sarahemm/continuity_tester/README.md

# continuity_tester
Continuity Tester design, optimized for reverse engineering PCBs
