sarahemm/continuity_tester/continuity_tester.brd

## EAGLE design continuity_tester.brd (2018-01-26)

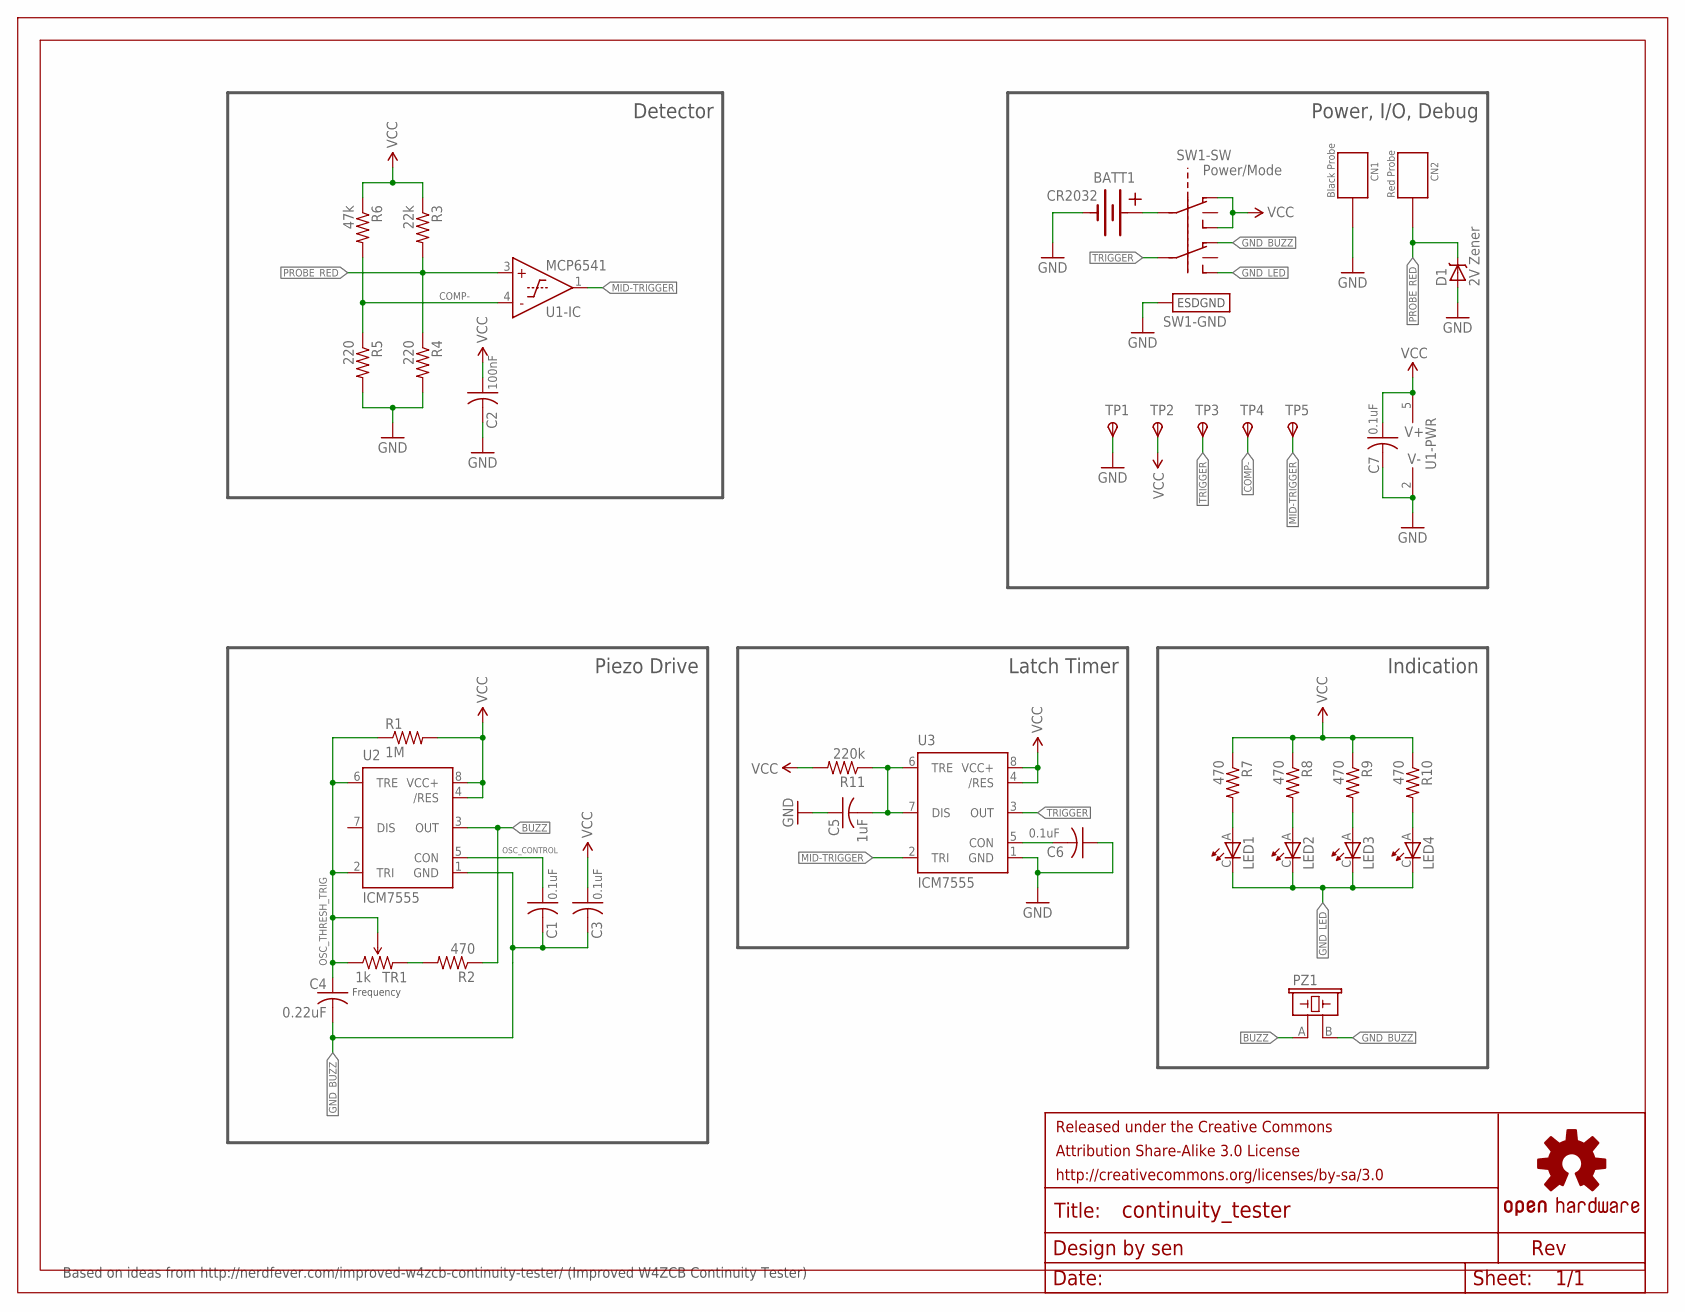
[picture p1: schematic continuity_tester.sch]

Parts:
BATT1: CR2032; BK-912-CR2032
C1, C3, C6, C7: 0.1uF; C0603
C2: 100nF; C0603
C4: 0.22uF; C0603
C5: 1uF; C0603
CN1: Black Probe; CALTEST-CT3151
CN2: Red Probe; CALTEST-CT3151
D1: 2V Zener; DO-219AC
FRAME1: FRAME-LETTER-GRID-OSHW-SENOSHW-LOGO-L; OSHW-LOGO-L
LED1, LED2, LED3, LED4: LITEON-LTST020
PZ1: MURATA-PKMCS0909
R1: 1M; R0603
R2, R7, R8, R9, R10: 470; R0603
R3: 22k; R0603
R4, R5: 220; R0603
R6: 47k; R0603
R11: 220k; R0603
SW1: Power/Mode; ESWITCH-EG2308
TP1: GND; B1,27
TP2: VCC; B1,27
TP3: TRIGGER; B1,27
TP4: COMP-; B1,27
TP5: MID-TRIGGER; B1,27
TR1: 1k; NIDEC-ST4EA
U1: MCP6541; SOT23-5
U2, U3: ICM7555; SO08

Connections:
BUZZ: PZ1.A (1), R2.1, U2.3 (OUT)
COMP-: R5.1, R6.2, TP4.TP, U1.4 (IN-)
GND: BATT1.- (-1), C2.2, C5.1, C6.1, C7.2, CN1.A, CN1.B, CN1.C, CN1.D, D1.A, R4.2, R5.2, SW1.SUPPORT1 (ESDGND), SW1.SUPPORT2 (ESDGND), TP1.TP, U1.2 (V-), U3.1 (GND)
GND_BUZZ: C1.2, C3.2, C4.2, PZ1.B (2), SW1.5 (2A), U2.1 (GND)
GND_LED: LED1.C, LED2.C, LED3.C, LED4.C, SW1.8 (2C)
LED1_R: LED1.A, R7.2
LED2_R: LED2.A, R8.2
LED3_R: LED3.A, R9.2
LED4_R: LED4.A, R10.2
MID-TRIGGER: TP5.TP, U1.1 (OUT), U3.2 (TRI)
OSC_CONTROL: C1.1, U2.5 (CON)
OSC_THRESH_TRIG: C4.1, R1.1, TR1.CCW, TR1.WIPER, U2.2 (TRI), U2.6 (TRE)
PROBE_RED: CN2.A, CN2.B, CN2.C, CN2.D, D1.K (C), R3.2, R4.1, U1.3 (IN+)
TR1_R2: R2.2, TR1.CW
TRIGGER: SW1.7 (2), TP3.TP, U3.3 (OUT)
U3-CON: C6.2, U3.5 (CON)
U3-TREDIS: C5.2, R11.1, U3.6 (TRE), U3.7 (DIS)
VCC: C2.1, C3.1, C7.1, R1.2, R3.1, R6.1, R7.1, R8.1, R9.1, R10.1, R11.2, SW1.1 (1A), SW1.4 (1C), TP2.TP, U1.5 (V+), U2.4 (/RES), U2.8 (VCC+), U3.4 (/RES), U3.8 (VCC+)
VCC_PRESWITCH: BATT1.+1 (+2), SW1.3 (1)

Notes on the sheet:
Frequency
Indication
Piezo Drive
Detector
Power, I/O, Debug
Based on ideas from http://nerdfever.com/improved-w4zcb-continuity-tester/ (Improved W4ZCB Continuity Tester)
Latch Timer

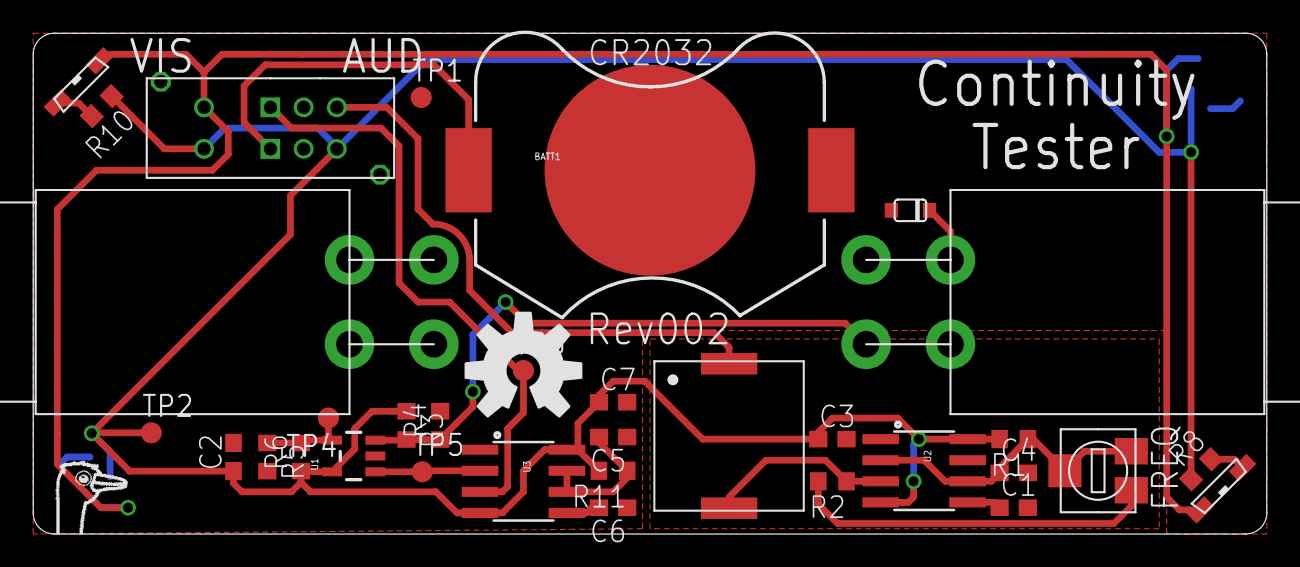
[picture p2: board continuity_tester.brd from above]

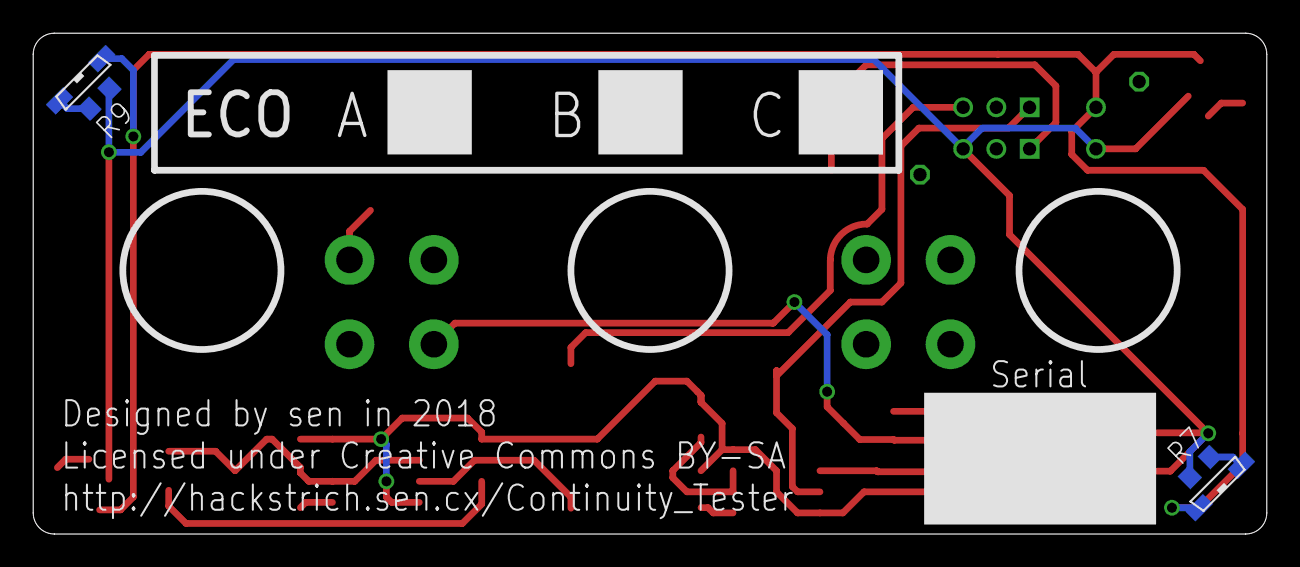
[picture p3: board continuity_tester.brd from below]

Board: 2 copper layers, 74.3 x 30.2 mm, 39 parts (4 on the bottom side), 19 nets.

Other parts of the board:
U$1: STRICH-LOGO-R
