sarahemm/continuity_tester/(commit log)

2017-12-12 Adding complete/checklisted schematic.
    [continuity_tester.sch]
2017-12-12 Board routing in progress.
    [continuity_tester.brd, continuity_tester.sch]
2017-12-13 Board routed and checklisted, ready for CAM.
    [continuity_tester.brd, continuity_tester.sch]
2017-12-13 Adding complete CAM files, ready to send for manufacturing.
    [continuity_tester.drills.xln]
2018-01-16 Started making Rev002 updates to schematic. Not currently in a usable state!
    [continuity_tester.brd, continuity_tester.sch]
2018-01-16 More improvements for Rev002 in progress.
    Extra 555 for latch timer in place.
    Replaced comparator w/ a push/pull one needed for latch, also uses 1/165th of the power of the old one.
    Replaced switch with one that's more appropriate and 1/5 the cost of the old one.
    [continuity_tester.brd, continuity_tester.sch]
2018-01-16 Rev002 schematic complete.
    [continuity_tester.brd, continuity_tester.sch, continuity_tester_bom.csv]
2018-01-16 Checklist for Rev002 schematic completed.
    [continuity_tester.brd, continuity_tester.sch, continuity_tester_bom.csv]
2018-01-18 Rev002 board layout electrically complete, still need to finish silkscreen and check it.
    [continuity_tester.brd, continuity_tester.sch]
2018-01-26 Completed and checklisted Rev002 schematic and board.
    [continuity_tester.brd, continuity_tester.sch]
2018-01-26 Rev002 CAM files generated and checklisted.
    [continuity_tester.drills.xln]
2018-01-26 Updated BOM for Rev002 and removed unneeded fields.
    [continuity_tester_bom.csv]
