sarahemm/continuity_tester/(notices)

Notices in the files:
continuity_tester.brd:
Licensed under Creative Commons BY-SA
parts and their libraries:
SparkFun-AnalogIC: Licensing:Creative Commons ShareAlike 4.0 International - https://creativecommons.org/licenses/by-sa/4.0
logos-sen: Released under the Creative Commons Attribution Share-Alike 3.0 License
logos-sen: http://creativecommons.org/licenses/by-sa/3.0
